akffkdzkdngmrdn87/AI-Guide-Dog_RPI4_Autonomous/docs/readme.md

AI 맹도견 자율주행 VLA 알고리즘 아키텍처
