akffkdzkdngmrdn87/AI-Guide-Dog_RPI4_Autonomous/필독.md

# ⚙️ Raspberry Pi 4 기반 Edge AI 하드웨어 및 소프트웨어 성능 최적화 가이드



본 문서는 제한된 컴퓨팅 자원(Raspberry Pi 4, 4GB RAM)을 활용하는 Edge 환경에서 다중 센서 융합(ROS 2) 및 비전 AI 추론 모델을 병렬 구동하기 위한 시스템 성능 최적화(Performance Tuning) 및 트러블슈팅(Troubleshooting) 표준 가이드라인입니다. 시스템의 신뢰성과 제어의 정칙성(Nonsingularity)을 보장하기 위해 구동 전 반드시 아래의 지침을 적용해야 합니다.

---

## 1. 최적화 목표 (Objectives)

자율주행 시스템 구동 시 ROS 2 통신 미들웨어와 ONNX Runtime 기반의 텐서(Tensor) 연산이 동시에 발생할 경우, 가용 메모리 초과로 인한 OOM(Out Of Memory) 킬러의 프로세스 강제 종료 현상이 발생할 수 있습니다. 이를 방지하기 위해 디스크 I/O 병목을 유발하는 기존의 물리적 스왑(Swap) 파티션을 제거하고, 커널 수준의 가상 압축 메모리(ZRAM) 블록 장치를 도입하여 I/O 대기 시간(Latency)을 수학적 하한선으로 최소화합니다.

## 2. 메모리 최적화 및 ZRAM 자동화 스크립트

시스템 전체 물리 메모리(4GB)의 **15%(약 600MB)**를 ZRAM으로 할당합니다. `lz4` 알고리즘의 평균 압축 비율(약 2.5:1)을 고려할 때, 600MB의 ZRAM은 약 1.5GB의 논리적 가상 메모리 공간을 제공합니다. 이는 물리 메모리의 약 3.4GB를 딥러닝 행렬 연산에 온전히 할당하면서도, 가비지 컬렉션(GC) 스파이크 발생 시 시스템의 안정성을 보장하기 위한 최적의 임계값입니다.

아래의 명령어를 터미널에 입력하여 설정을 일괄 적용하십시오.

```bash
sudo swapoff -a && sudo rm -f /swapfile /swap.img && sudo sed -i '/swap/d' /etc/fstab && sudo apt-get update && sudo apt-get install -y zram-tools && sudo systemctl stop zramswap 2>/dev/null; sudo swapoff /dev/zram0 2>/dev/null; sudo zramctl --reset /dev/zram0 2>/dev/null; sudo rmmod zram 2>/dev/null; sudo modprobe zram && sudo sh -c 'printf "ALGO=lz4\nPERCENT=15\n" > /etc/default/zramswap' && sudo sed -i '/vm.swappiness\|vm.vfs_cache_pressure\|vm.dirty_ratio\|vm.dirty_background_ratio/d' /etc/sysctl.conf && sudo sh -c 'printf "vm.swappiness=100\nvm.vfs_cache_pressure=50\nvm.dirty_ratio=10\nvm.dirty_background_ratio=5\n" >> /etc/sysctl.conf' && sudo sysctl -p && sudo systemctl enable zramswap && sudo systemctl restart zramswap && swapon --show && free -h
```

* **적용 상태 검증:** 명령어 실행 완료 후 반환되는 `free -h` 출력 결과에서 `Swap:` 항목의 총 용량이 `560Mi` 내외로 표기되는지 확인하십시오. 해당 커널 매개변수는 재부팅 시 영구 적용됩니다.

---

## 3. 하드웨어 트러블슈팅 가이드 (Hardware Troubleshooting)

### 3.1. 모터 구동 방향 역전 (Polarity Inversion) 현상
* **증상:** 소스 코드 변경이 부재함에도 제어 입력(Teleop/AI)과 로봇의 구동 방향이 역상(Inverse Phase)으로 나타나는 현상.
* **원인:** 기체 재조립 과정에서 하부 제어기(L293D 모터 드라이브 단자대)에 연결된 DC 모터 배선의 극성이 반대로 체결되어 발생하는 물리적 역기전 현상입니다.
* **해결책:** 소프트웨어 제어 변수 부호를 임의로 반전시킬 경우 기구학적 모델(Kinematic Model)의 일관성이 훼손됩니다. 오류가 발생한 구동륜 단자대의 물리 전선 2가닥 위치를 드라이버를 사용하여 **상호 교차 체결(플러스/마이너스 극성 스왑)**함으로써 하드웨어 레벨에서 위상을 보정하십시오.

### 3.2. 라이다(LiDAR) 자아 인지 간섭 (Self-Occlusion Deadlock)
* **증상:** 주행 가능 영역이 확보되었음에도, 장애물 회피 알고리즘이 임계거리 침범으로 판단하여 제어 입력 속도를 영벡터($v = 0.0$)로 강제 수렴시키는 현상.
* **원인:** LiDAR 센서의 2D 레이저 스캔 반경($r$) 내에 기체 자체의 프레임 또는 점퍼 와이어가 간섭물로 위치하여, 이를 동적/정적 장애물로 오인하는 폐루프(Closed-loop) 오류입니다.
* **해결책:** 1. 기계적 조치: LiDAR 측정 고도(Z-axis) 및 360도 수평 평면상에 와이어 간섭이 발생하지 않도록 배선을 하단으로 고정하십시오.
  2. 알고리즘적 조치: 레이저 스캔 콜백(Callback) 함수 내부에서 조건식(`ranges < 0.15m`)을 검토하여, 기체 구조물 반경 이내의 점군(Point Cloud) 데이터를 노이즈로 간주하고 필터링(Spatial Filtering)하십시오.

### 3.3. MPU-6050(IMU) I2C 통신 마비 및 EMI(전자파 간섭) 현상
* **증상:** DC 모터 기동 순간 I2C 버스 라인이 동결되거나, 가속도 Z축 벡터 크기가 중력 가속도($1G$)를 정규화하지 못하고 극심한 분산(Variance)을 보이는 현상.
* **원인:** 브러시 DC 모터 회전 시 발생하는 고주파 스파크 노이즈와 서지 전류(Surge Current)가 제어 로직 회로(5V/3.3V)에 전압 강하(Brownout) 및 전자기 간섭(EMI)을 유발하기 때문입니다.
* **해결책:** 1. 회로 분리: Raspberry Pi(제어부)와 모터 드라이브(구동부)의 전원 소스를 물리적으로 격리하고, 참조 전위 동기화를 위해 GND 라인만 상호 결속(Common GND)하십시오.
  2. 디커플링(Decoupling): 각 모터의 단자 사이에 **0.1µF 세라믹 커패시터**를 병렬로 납땜하여 고주파 노이즈를 저대역 필터링하십시오.
  3. 소프트웨어 보정: IMU 초기화 코드 내에 디지털 저역통과필터(DLPF, 10Hz)를 활성화하여 고주파 진동 성분을 소프트웨어적으로 감쇠하십시오.

```cpp
// 아두이노 setup() 내 MPU-6050 EMI 노이즈 차단 및 레지스터 초기화
Wire.beginTransmission(0x68); Wire.write(0x6B); Wire.write(0x80); Wire.endTransmission(true); delay(100); // 디바이스 리셋
Wire.beginTransmission(0x68); Wire.write(0x6B); Wire.write(0x00); Wire.endTransmission(true); delay(100); // 절전 모드 해제
Wire.beginTransmission(0x68); Wire.write(0x1A); Wire.write(0x05); Wire.endTransmission(true); // DLPF(10Hz) 활성화
```

### 3.4. 초음파 센서 동기식 처리 병목 (Blocking Latency) 현상
* **증상:** 메인 제어 루프의 주기가 저하되어, 로봇의 동적 장애물 회피 응답 시간(Response Time)이 지연되는 현상.
* **원인:** `pulseIn()` 함수는 초음파의 비행 시간(Time of Flight, $t = 2d/v$)을 동기식으로 대기하여, 단일 스레드를 블로킹(Blocking) 상태로 만듭니다.
* **해결책:** 타이머 인터럽트 기반의 비동기 처리 라이브러리(`NewPing`)와 `millis()` 함수를 활용하여 연산 병렬성을 확보하고, MCU와 메인 보드 간의 시리얼 통신 대역폭(Baud rate)을 `115200 bps`로 상향 조정하여 통신 대기 시간(Queue Delay)을 최소화하십시오.

---

## 4. 소프트웨어 트러블슈팅 가이드 (Software Troubleshooting)

### 4.1. Nav2 DWB 제어기 역행렬 특이점 (ZeroDivision) 현상
* **증상:** RViz2 상에서 지도 생성은 진행되나, Nav2 Goal (목표점) 인가 시 추정 필터(EKF) 노드가 특이점(Singularity) 예외를 발생시키며 붕괴하는 현상.
* **원인:** 2D 평면 주행 환경에서 측정되지 않는 상태 변수(Z축 위치, Roll, Pitch 방향)에 대한 공분산(Covariance) 행렬 대각 원소가 0으로 입력될 경우, 제어 알고리즘 내부의 역행렬 산출 수식에서 0으로 나누기 연산이 발생합니다.
* **해결책:** 오도메트리 퍼블리셔(`odom`) 생성부에서, 물리적으로 변동이 없는 상태 변수에 대해 극댓값($10^6$)을 임의로 할당하여 해당 차원에 대한 필터 갱신 가중치를 소거하고 행렬의 정칙성(Nonsingularity)을 강제하십시오.

```python
# real_odom_publisher.py 내 공분산 행렬 정칙성 확보
odom.pose.covariance = [0.01, 0.0, 0.0, 0.0, 0.0, 0.0,
                        0.0, 0.01, 0.0, 0.0, 0.0, 0.0,
                        0.0, 0.0, 1e6, 0.0, 0.0, 0.0,
                        0.0, 0.0, 0.0, 1e6, 0.0, 0.0,
                        0.0, 0.0, 0.0, 0.0, 1e6, 0.0,
                        0.0, 0.0, 0.0, 0.0, 0.0, 0.03]
odom.twist.covariance = odom.pose.covariance
```

### 4.2. RViz2 좌표계 점진적 회전 (Phantom Rotation/Drift) 에러
* **증상:** 정지 상태임에도 RViz2 상에서 로봇의 로컬 좌표계(TF)와 센서 데이터가 일정한 각속도로 회전하는 누적 오차 현상.
* **원인:** 자이로스코프(Gyroscope) 센서 고유의 기계적 바이어스(Bias) 값이 0이 아닐 경우, 각속도 적분 식 $\theta = \int (\omega - \omega_{bias}) dt$ 에서 $\omega_{bias}$ 항이 지속적으로 오차를 누적시킵니다.
* **해결책:** 시스템 부팅 초기, 기체가 완전 정지된 상태에서 일정 횟수($N \ge 500$)의 자이로 원시 데이터를 수집하여 산술 평균을 산출하고, 이를 바이어스 변수($\omega_{bias}$)로 저장한 후 런타임 계산 시 차감하는 캘리브레이션 루틴을 구현하십시오.

### 4.3. 주행 데이터 수집 중 네트워크 패킷 병목 (Packet Drop)
* **증상:** 무선 원격 환경에서 `rosbag2`를 통해 멀티모달 센서 데이터(이미지, 라이다, IMU) 기록 시, 대량의 프레임 유실이 발생하는 현상.
* **원인:** 비압축 이미지 및 고주파 센서 데이터의 총 전송률(Throughput)이 Wi-Fi 무선 네트워크의 가용 대역폭을 초과하여 TCP/UDP 패킷 드롭이 발생합니다.
* **해결책:** 원격 노드에서의 데이터 수집(Logging) 아키텍처를 폐기하고, 로봇 본체의 Raspberry Pi 4에 장착된 내부 버스 저장매체(SD Card)에 I/O 파이프라인을 직접 연결하여 내부 기록(`rosbag2 record -o`) 방식으로 전환하십시오.

---

## 5. 교차 검증 및 참조 문헌 (References)
본 가이드라인에 명시된 해결책은 다음의 학술적/공학적 검증 문헌 및 공식 프레임워크 문서를 기초로 설계되었습니다.
1. **EMI & Decoupling (IEEE):** "Electromagnetic Compatibility Engineering" (H. W. Ott) - DC 브러시 모터 구동 환경에서의 바이패스 커패시터 적용 및 신호 무결성 확보 원리.
2. **Asynchronous I/O (CMU Robotics Institute):** 실시간 임베디드 제어 시스템 설계 시 동기식 대기(Polling/Blocking) 함수 지양 및 인터럽트 기반 비동기 설계 패턴에 관한 연구.
3. **EKF Covariance Matrices (ROS 2 NavStack Documentation):** 확장 칼만 필터(EKF)의 수학적 구현에서 관측 불가능한 차원의 공분산 행렬 정칙성 확보를 위한 대각 원소 가중치 부여 방법론.
4. **Linux Kernel Memory Management:** 리눅스 커널 매개변수(`vm.swappiness`, `vfs_cache_pressure`) 조정을 통한 OOM 방지 및 ZRAM 블록 디바이스 압축 효율화 분석 (Kernel.org 공식 기술 문서).

### - 이상 자세한 추가 사항은 media 폴더 안에 html 파일을 통해서 확인하십시오 -
