akffkdzkdngmrdn87/AI-Guide-Dog_RPI4_Autonomous/src/README.md

.py는 라즈베리파이4에
.ino는 아두이노 우노 + L293D 모터 쉴드 드라이브에 복사하세요.
