akffkdzkdngmrdn87/AI-Guide-Dog_RPI4_Autonomous/docs/AI 맹도견 자율주행 VLA 알고리즘 아키텍처.png

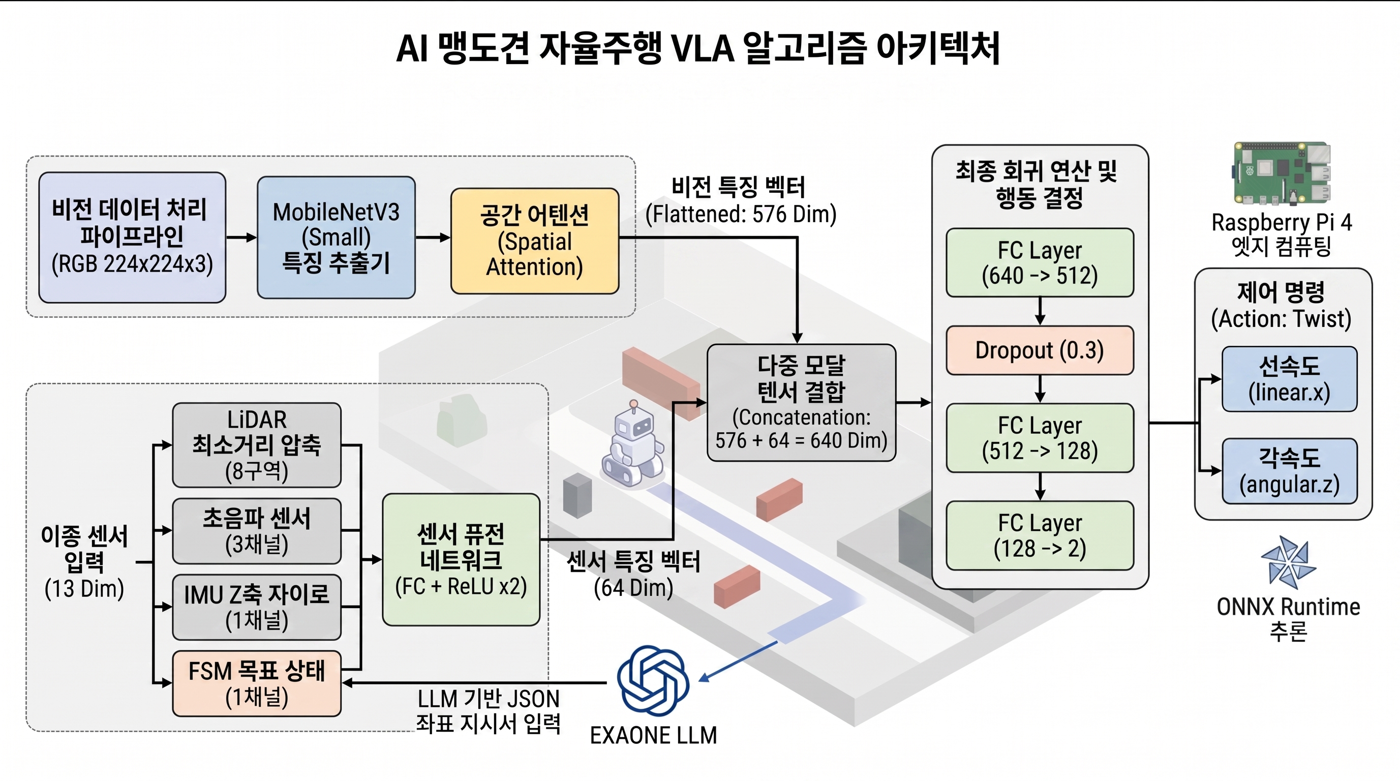
docs/AI 맹도견 자율주행 VLA 알고리즘 아키텍처.png
