akffkdzkdngmrdn87/AI-Guide-Dog_RPI4_Autonomous/media/로봇우측.jpg

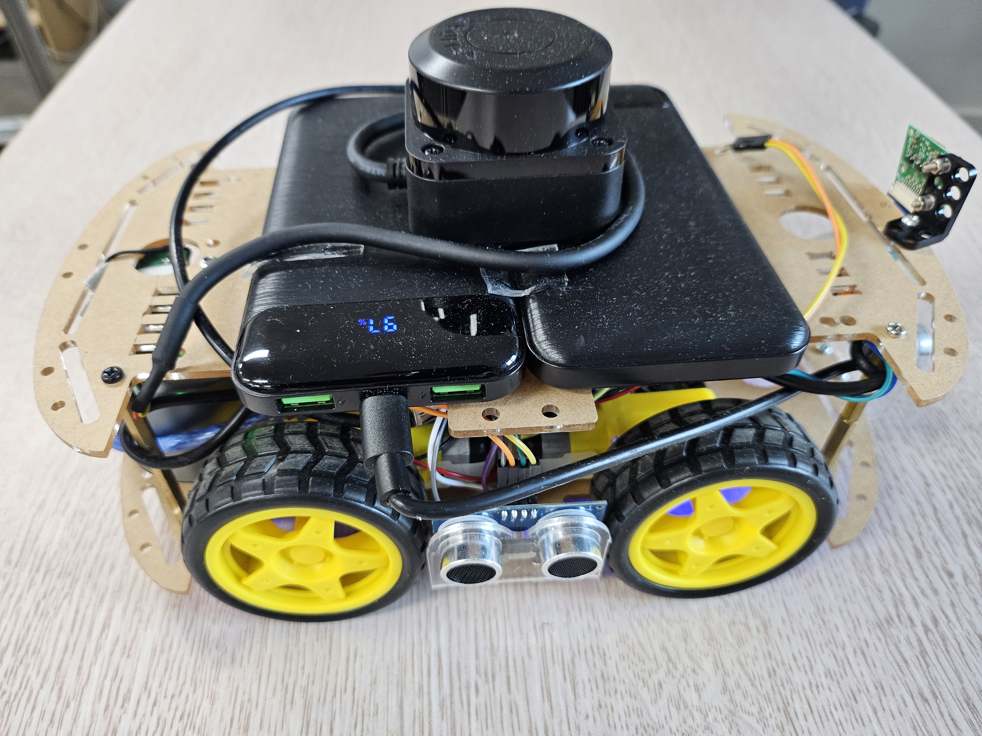
media/로봇우측.jpg
