akffkdzkdngmrdn87/AI-Guide-Dog_RPI4_Autonomous/media/로봇정면.jpg

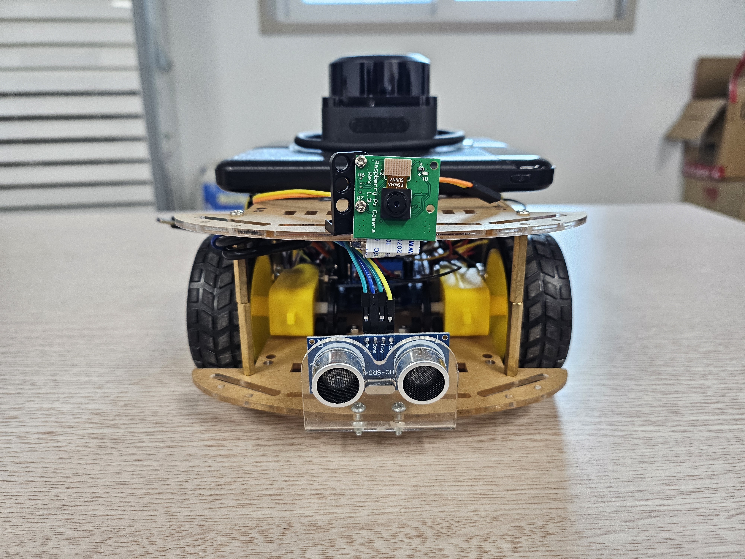
media/로봇정면.jpg
