akffkdzkdngmrdn87/AI-Guide-Dog_RPI4_Autonomous/docs/training_results_korean.png

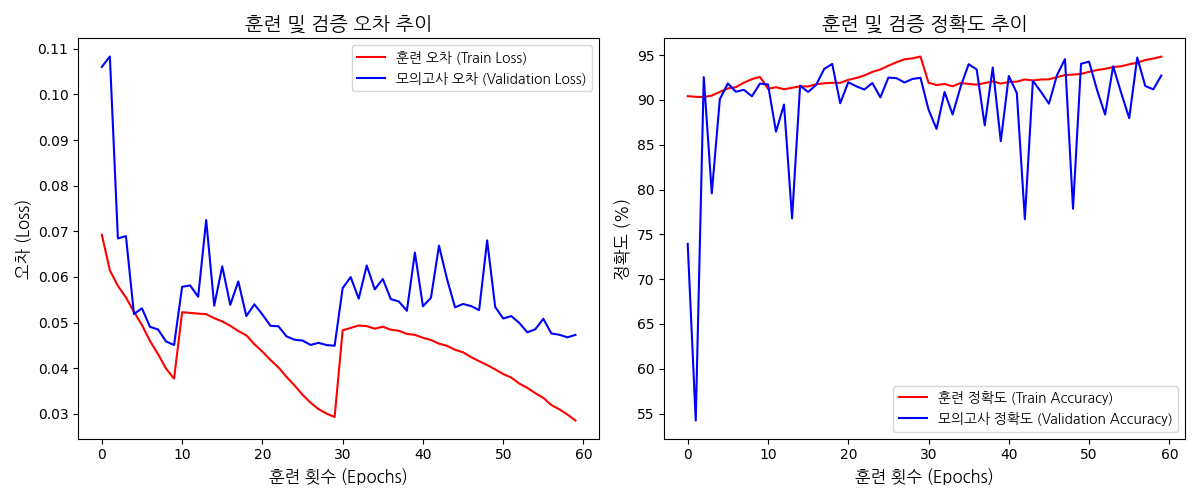
docs/training_results_korean.png
