akffkdzkdngmrdn87/AI-Guide-Dog_RPI4_Autonomous/media/로봇주행사진1.jpg

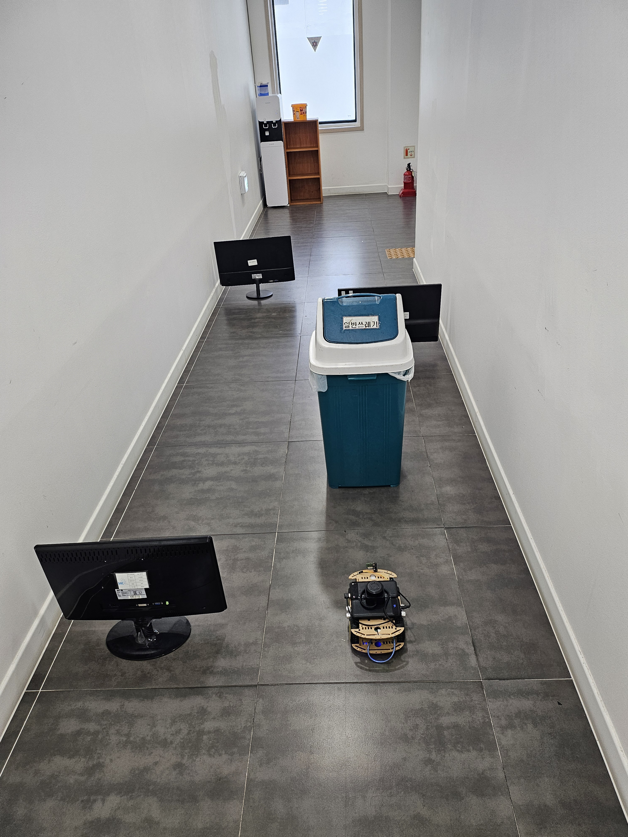
media/로봇주행사진1.jpg
